p-v-o-s/sky-sweep/prototypes/sky-shield-v0.4-top.png

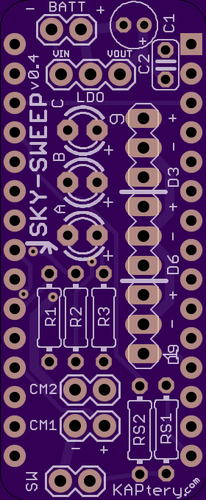
prototypes/sky-shield-v0.4-top.png
