p-v-o-s/sky-sweep/prototypes/sky-shield-v0.1-schem.png

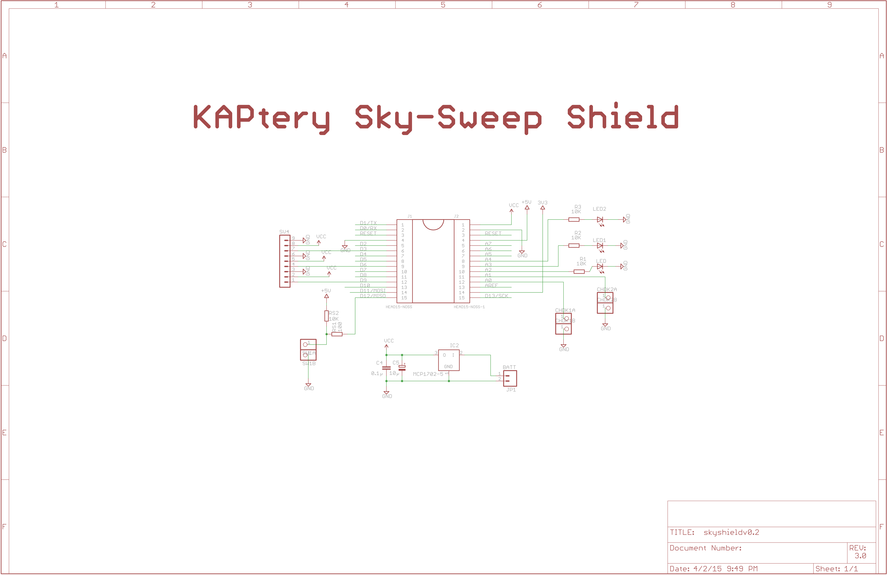
prototypes/sky-shield-v0.1-schem.png
