p-v-o-s/sky-sweep/prototypes/sky-shield-v0.5-board.png

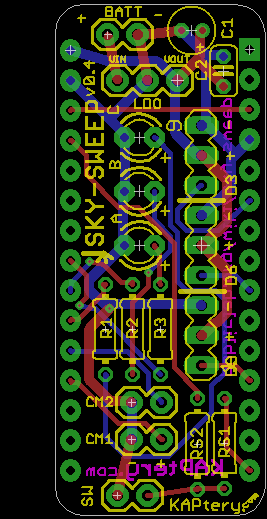
prototypes/sky-shield-v0.5-board.png
