p-v-o-s/sky-sweep/prototypes/sky-sweep-v0.2-bottom.png

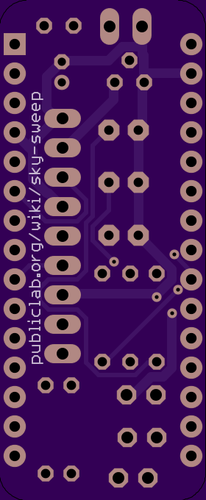
prototypes/sky-sweep-v0.2-bottom.png
