p-v-o-s/sky-sweep/ver_2.3/hardware/skyshieldv2.3-schematic.png

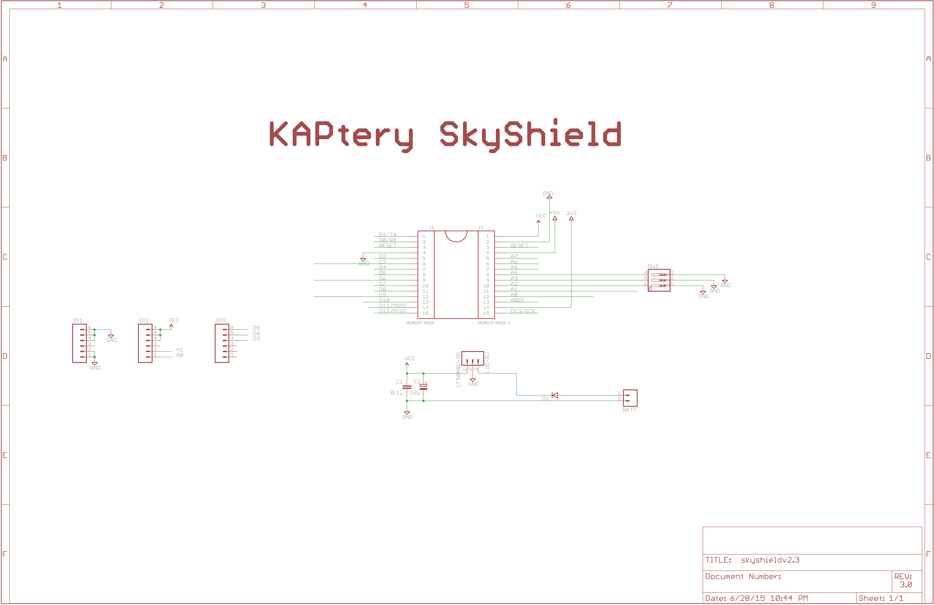
ver_2.3/hardware/skyshieldv2.3-schematic.png
