p-v-o-s/sky-sweep/(threads)

Thread 1 (2015-04-02):

add 5V voltage regulator from VIN

dwblair, 2015-04-02:
Might use this:

MICROCHIP  MCP1702-5002E/TO  LDO VOLTAGE REGULATOR, 5V, 250mA, TO-92-3

http://www.newark.com/microchip/mcp1702-5002e-to/ldo-voltage-regulator-5v-250ma/dp/56K6985?mckv=sGFSVLldl|pcrid|57087227901|plid|&CMP=KNC-GPLA?gross_price=

Closed 2015-06-05.

Thread 2 (2015-06-05):

Create BOM

dwblair, 2015-06-05:

Fastie, 2015-06-14:
Don,
I updated the SkyShield [bill of materials google sheet](https://docs.google.com/spreadsheets/d/1GBuHSpaCLA2EbN3OOJWe4kTiJWiZ1Trc5mMFSvcZXjI/edit#gid=2020475328). There are now sheets for Version 0.4 (in beta), Version 2.0 and 2.1 (at OSH, will have DIP switch) and Version 3 (not designed, will have boost converter). It would be good to place a Digi-Key order for DIP switches, resistor networks, and other stuff for Version 2 in the next few days. Could you source the resistor network, confirm my DIP switch choice, and confirm that Version 2 still needs the resistors and capacitors that version 0.4 needed?

I could also include in this Digi-Key order a boost converter and anything else needed for Version 3. That is not designed yet, but I hope it will be in time to order some PCBs from OSH as soon as Version 2.1 is confirmed to work (this month). That way we could have Version 3 back from OSH and ready to try when I return from field work. In fact, if you come up with a design for Version 3 like now, I will order a few and maybe get to test it before I ship out, which could move the timeline up by two weeks.

There are notes to you in the Google sheet.
Thanks

dwblair, 2015-06-14:
Great!  I'll get on resistor network, DIP switch, and associated resistors and capacitors ...

Love the boost converter idea.  I think the part that was pointed to was a 'surface mount' part, and I haven't looked at the associated 'package', but depending, it might be more or less easy as a DIY kit.  @bgamari  has pointed to the fact that some surface mount packages are actually easier to solder than through-hole, though, so maybe this will work out well ... will look into it.

Fastie, 2015-06-14:
Here are some [through-hole step-up boost converters at Digi-Key](http://www.digikey.com/product-search/compare/en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). These are all 8 pin ICs (7.6mm), so they take up a lot of room on the shield.   But they all cost <$0.65.

Fastie, 2015-06-14:
[Here are more](http://www.digikey.com/product-search/compare/en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) for mostly <$1.00 includiing some that are ratiometric, whatever that means. These are all through-hole ICs. Could these be soldered on the underside of the shield to allow something to go in its footprint on top?

bgamari, 2015-06-15:
@Fastie, be aware that the second group of parts (the "ratiometric" ones) actually produce a negative voltage (this type of device is known as a switched capacitor charge pump). You really want something like the parts in the first list, which are [buck-boost regulators](https://en.wikipedia.org/wiki/Boost_converter) (where you are instead using an inductor as your energy storage element).

Fastie, 2015-06-15:
Thanks Ben. Good to know what ratiometric means, and that we don't want it.

bgamari, 2015-06-15:
Well, to be clear it's not that you don't want a ratiometric part. "Ratiometric" in this case just means that the output voltage is proportional to the ratio of two external component values (in this case resistors).

Also, it seems I mixed up the two sets of parts that you cited. You can filter for the desired parts on Digikey's website by selecting the  "Boost" and "Buck-boost" topologies.

Fastie, 2015-06-15:
Hmm, all the boost and buck-boost through-hole converters are expensive ([cheapest ones](http://www.digikey.com/product-search/compare/en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)).
The surface mount versions are way more abundant and cheaper ([cheapest ones](http://www.digikey.com/product-search/compare/en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)).
Can we ask kit builders to solder on a surface mount component?

BobStevens, 2015-06-15:
I've been using the mini buck-boost modules from Pololu, on an unrelated
project, and they seem to work well. Easy to solder.
When used with servos an additional capacitor on the Vout helps a lot. But
perhaps too expensive to include in the kit.

The board and schematic can be found here...
https://www.pololu.com/product/2119/resources

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

bgamari, 2015-06-15:
Looks like they are a bit expensive and may not have the capacity to drive the load in question.

Fastie, 2015-06-16:
Thanks for that link Bob. That Pololu module seems to do just what we need, although it would be good to be able to handle about 1.5A. I haven't been able to find one of the IC modules at Digi-Key that is step-up/step-down and in the correct voltage range for a reasonable price. The servos seem to need between 4.8 and 6 volts. I think closer to 6V is better. There are lots of IC converters for under $2.00, but I'm not sure any of them do what we need. I'm still not sure adding $5.00 to the BOM is justified. I also don't know which of those surface mount converters can be soldered by hand.

I just got the news that six new SkyShield PCBs were shipped from Oregon today. So the more pressing need is the final components for SkyShield v2 and 2.1 (DIP switch, resistor network, etc.). A Digi-Key order should go in ASAP, then we have more time to figure out if a boost converter can be added for v3.

dwblair, 2015-06-16:
 Hallo!

Yes, let me get back in here and review the components for v2 and v2.1 ...

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

dwblair, 2015-06-16:
Good news: confirmed number of capacitors, added in resistor network option
on digikey!

Potentially bad news: in discussion w/ Ben, might've done something that
won't quite work w/respect to the DIP switch. Going to prototype it tonight
to find out ...

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

dwblair, 2015-06-17:
Update:

When I checked the parts for v.2.1 and v.2.2, something looked odd to me in
the switch circuit.  Specifically, there was no "ground" for any of the
switches -- so that when the switch is open, the voltage measured on the
analog pins will 'float'.  (This is in contrast with our other switch /
button circuit, which is grounded when it's not closed -- and is what
tipped me off.)

In conversation with @bgamari (The Oracle), he proposed a simple fix for
this.  Arduino pins are capable of 'internal pull-up resistors' -- i.e.,
through firmware code you can decide to connect individual pins to VCC via
an internal resistor.

So: if we connect the individual switches in the DIP switch to ground,
instead of VCC, we can also 'pull up' all of the resistors via an internal
pull-up resistor in firmware.

This doesn't work as a fix for boards version 2.0 and 2.1 -- in order to
fix those boards, you'll need to 'cut the trace' (the PCB metal connecting
the switches to VCC) on the board (done with a knife or equivalent), and
then solder a wire from the relevant pin on the resistor network to GND.
This won't be a great option for a commercial kit, and you likely won't
want to sell boards with this fix (though I'm sure you can do it in an
elegant way) -- but @bgamari pointed out that it might be worth ordering
the resistor network part in order to test the circuit at least once,
anyway.

The upside of this is that we can actually get away without using the
resistor network at all, making more space on the board (for, e.g., the
components required for a switching regulator -- which will require not
just the switching reg IC, but some additional capacitors / inductor / etc.)

Sorry for the goof-up.

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
>>> Thanks for that link Bob. That Pololu module seems to do just what we
>>> need, although it would be good to be able to handle about 1.5A. I haven't
>>> been able to find one of the IC modules at Digi-Key that is
>>> step-up/step-down and in the correct voltage range for a reasonable price.
>>> The servos seem to need between 4.8 and 6 volts. I think closer to 6V is
>>> better. There are lots of IC converters for under $2.00, but I'm not sure
>>> any of them do what we need. I'm still not sure adding $5.00 to the BOM is
>>> justified. I also don't know which of those surface mount converters can be
>>> soldered by hand.
>>>
>>> I just got the news that six new SkyShield PCBs were shipped from Oregon
>>> today. So the more pressing need is the final components for SkyShield v2
>>> and 2.1 (DIP switch, resistor network, etc.). A Digi-Key order should go in
>>> ASAP, then we have more time to figure out if a boost converter can be
>>> added for v3.
>>>
>>> —
>>> Reply to this email directly or view it on GitHub
>>> <https://github.com/p-v-o-s/sky-sweep/issues/2#issuecomment-112271345>.
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

dwblair, 2015-06-17:
Here's a new version of the shield (2.2) incorporating the changes
(simplified switch circuit):

https://github.com/p-v-o-s/sky-sweep/tree/master/ver_2.2/hardware

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
>>>  Hallo!
>>>
>>> Yes, let me get back in here and review the components for v2 and v2.1
>>> ...
>>>
>>> On Mon, Jun 15, 2015 at 11:23 PM, Fastie <notifications@github.com>
>>> wrote:
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

bgamari, 2015-06-17:
dwblair <notifications@github.com> writes:

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
Looks good to me.

Fastie, 2015-06-17:
So there is code you use in a sketch to make a particular pin gets its current through a resistor on the Nano? Only the pins used for the DIP switch will be routed through this resistor? Anybody know this code?
With some scratches and jumpers can I test this with the PCBs that will arrive soon? That is, without a resistor network, can I wire it up so the DIP switch works? Are any other components needed for this test?
If the next version will not have a resistor network, is there any reason to order one for testing?

BobStevens, 2015-06-17:
INPUT_PULLUP is the mode,
http://www.arduino.cc/en/Reference/PinMode
 On Jun 17, 2015 12:21 PM, "Fastie" <notifications@github.com> wrote:

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

dwblair, 2015-06-17:
 Actually, great point -- there's no need to order the resistor network. In
fact, *not* placing the resistor network makes  testing easier -- you can
connect a wire from one of the resistor network holes directly to ground,
without having to cut any traces.  So really, you only need wires and
solder.  There is one pin on the resistor network footprint that is
connected to VCC, but each of the other pins would simply be connected to
ground (each separately).

Thanks Bob for the link -- yes, that looks like the right code, there!

On Wed, Jun 17, 2015 at 12:26 PM, BobStevens <notifications@github.com>
wrote:

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

Fastie, 2015-06-17:
So for a 3 switch DIP, I will need 3 jumpers, each from ground to a different hole (where the resistor network would have been). Wouldn't that be the same as connecting all the holes and running one jumper to ground? Could you doodle the jumpers required?

One jumper should not bother potential beta testers, although the plan was to have this round of testers get a kit for soldering the PCB. This version might not make a good test of that.

 I will place an order for DIP switches, but I have enough of everything else.

I guess I could order some version 2.2 PCBs from OSHPark, but I won't get to try them until late July. Will there be a version 3 with boost converter by then? Or is finding a boost converter for <$5.00 going to be hard?

dwblair, 2015-06-17:
Ah, you're right -- all of the switch ends can be connected to ground together, so that's easier.

For some reason I'm unable to change the line color in Inkscape any longer. Oops.  But hopefully you can discern what I'm getting at here:

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

Not yet sure re: the boost converter ... but sounds reasonable to shoot for late July, fi we can find a cheap part ...

Fastie, 2015-06-17:
Thanks for the doodle. The jumpers could be underneath so they won't even show. For v 2.1 with a four-switch DIP, it should be as you show.  For v. 2.0 with a three-switch DIP, can I connect only three holes (which three)?
It sounds like this could be a quite functional SkyShield and the DIP switch is an important upgrade to test. I have all the parts for six new rigs printed, so I could run another beta test. I probably won't have time to assemble the rigs before I ship out, but maybe beta testers can test the whole kit process this time. I just have to create assembly instructions and the DIP switch code. Bob, thanks for the link to the  PinMode page.

Thread 3 (2015-06-05):

USB power flakiness -- exploring

dwblair, 2015-06-05:

Fastie, 2015-06-07:
I added to the description of this power issue sufficient detail that someone familiar with circuits and power could probably diagnose it.

bgamari, 2015-06-09:
Indeed most USB ports are limited to 500mA. A standard servo may draw upwards of an amp when starting. This almost certainly explains the behavior you see.

Also, something to note is that even when not moving some servos can draw quite a bit (tens of milliamps). A simple solution to both of these problems would be to put the servos behind a switch-mode boost converter. This will allow you to use fewer batteries (as the battery voltage is no longer constrained by the voltage requirements of the servos) and allows you to easily switch off the servos when not needed.

Fastie, 2015-06-09:
Thanks Ben. So USB 2.0 just can't supply the current that servos need.

A boost converter would solve that problem and supply more reliable power from batteries as well. It looks like a boost converter would cost as much as all the components of the SkyShield combined and be almost as big as the entire SkyShield.

I guess since the SkyShield functions as desired under battery power, which is the intended mode for aerial photography, it might be best to leave it as is. Testing new sketches downloaded via USB will require that battery power is on (whether USB is still connected or not).

Fastie, 2015-06-09:
Maybe we shouldn't lay all the blame on USB. USB connects to the Nano, not the SkyShield, so USB power getting to the pins on the shield goes through the Nano which is rated for only 40mA output. That is certainly not enough to drive servos, and a primary function of the SkyShield is to supply adequate power to the servos because an Arduino alone can't do that.

The 1.5A LDO voltage regulator on the SkyShield is a better power source than USB, but the 500mA direct from USB should be enough to handle the servo motion it is being asked to do.

Unless there are output pins on the Nano that could supply the USB current directly to the SkyShield, there are no changes to the SkyShield that could fix this problem. The servos will never work well if all the power they get is from the 40mA Nano output. If there is a pin on the Nano that supplies unfiltered USB power, the SkyShield could direct that to the servos, with or without regulation or boosting. Is there such a pin?

There must be, because the Funduino shield drives servos just fine and has headers intended to do just that. With USB connected to the Nano, servos plugged in to the Funduino operate as they should. What does the Funduino do that the SkyShield doesn't?

Fastie, 2015-06-10:
From this post: <http://electronics.stackexchange.com/questions/67092/how-much-current-can-i-draw-from-the-arduinos-pins>

"The 5V pin of the arduino is *not connected through the microcontroller.* As such, it can source significantly more power. When you are powering your arduino from USB, the USB interface limits your total power consumption to 500 mA. This is shared with the devices on the arduino board, so the available power will be somewhat less...

...The 5V output pin is good for ~400 mA on USB, ~900 mA when using an external power adapter."

I think the SkyShield uses this 5V pin on the Nano to get power when it is connected to USB. So it should have about 400mA to work with. That's not overly generous for servos, but should be plenty for testing. Is it possible that the SkyShield is preventing some of this current from getting to the servos?

bgamari, 2015-06-10:
Hmm. A simple boost converter should cost around a dollar with all of the passives. The converter itself will be roughly 20mm^2, with perhaps another 20mm^2 of routing and passives. Surely the board isn't *that* small. Moreover, the potential reduction in battery size would likely outweight the larger board area.

As far as the servos go, the problem may be a transient high current requirement. It is possible that some capacitance on the 5V rail may smooth out this transient

bgamari, 2015-06-10:
For instance, this would be one possible switcher, http://www.ti.com/product/lmr61428.

Fastie, 2015-06-10:
Ah, 60¢ and 3x5mm. That's more like it. My searches were finding something else.  That's even cheaper than the LDO on the SkyShield now.

The LDO is in the circuit right after the battery input, but that has no effect on power coming from USB. The boost converter could replace the LDO but get behind both the battery and the 5V pin so any power going to the servos gets boosted.

The battery we're using now is minimal because 4 AAA alkaline are only 6V and the servos should have at least 4.8V.  So when the batteries get a little worn out they stop driving the servos properly. I guess a boost converter could allow those same AAA to last much longer.

It sounds like a worthwhile addition.

bgamari, 2015-06-11:
Indeed, you could drop that down to 2 batteries at the expense of some capacity, some of which you would win back as the boost converter can maintain adequate rail voltage even as the battery voltages sag. With some effort you could probably find a boost converter with a minimum voltage of 1V, allowing you to operating with one alkaline battery although it's not clear it would give you enough capacity.

Fastie, 2015-06-11:
It might be best to stay with the four AAA so users can be confident that they have enough power to last for an afternoon of flying. With just two batteries, you would probably want fresh batteries for every one hour flight. Eventually you will send the rig up for an hour and then learn that the batteries lasted only 10 minutes, but with four AAAs and the right boost converter, that will happen on fewer flights.

Boost converters are available in through hole configuration, but there are zillions of them at Digi-Key. Our current LDO is mounted underneath the SkyShield so it takes up little space (it ends up between the SkyShield and the Nano).

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

Don, can you find an appropriate converter for 4 AAA and figure out if can fit on the SkyShield? The new SkyShield v2.1 will arrive in the next couple of weeks so its time to put in a Digi-Key order for components for those. So we need to select a resistor network and DIP switch, too. I can include in that order a couple of boost converters to try out for SkyShield V. 3.0.

dwblair, 2015-06-18:
Specs on this particular chip look maybe okay? https://learn.adafruit.com/adafruit-powerboost-1000-basic

Fastie, 2015-06-18:
It would be slick to be able to use two AAA instead of four. It would also be nice to use rechargeable batteries (which are 1.2V instead of 1.5V for alkaline). But that module is about half the size of the entire SkyShield, and costs more than all the other components combined (including the Nano).

There are two reasons to change the power circuit.

 -   1) fix the issue about USB power not driving servos correctly, and
 -   2) supply more carefully regulated power so batteries last longer and so fewer batteries are needed.

Is it possible to move the LDO we now use so that it regulates the power coming from the USB port on the Nano? Would this fix problem 1?

The existing configuration works really well in flight. Four AAA batteries last for at least 1.5 hours and maybe much longer (not yet tested). Lifting four AAA is not an obstacle to kite photography most of the time. So that part (number 2) ain't really broke.

I don't think it's worth adding 50% or 100% to the BOM to fix either 1 or 2, but if there is a way to fix problem 1 without adding more than a few dollars and enlarging the SkyShield footprint, it would be great to find it.

bgamari, 2015-06-18:
@Fastie I suspect Don was suggesting the chip on that board (the [TPS61030](http://www.ti.com/product/tps61030)) and not the board itself. It is [available](https://octopart.com/search?q=TPS61030) in a TSSOP package in single quantities for about $3. It's certainly not the cheapest option but I agree that the specs look pretty nice.

Fastie, 2015-06-23:
Just came across [this on Adafruit](https://learn.adafruit.com/adafruit-arduino-lesson-14-servo-motors/if-the-servo-misbehaves):
"Your servo may behave erratically, and you may find that this only happens when the Arduino is plugged into certain USB ports. This is because the servo draws quite a lot of power, especially as the motor is starting up, and this sudden high demand can be enough to drop the voltage on the Arduino board, so that it resets itself.
If this happens, then you can usually cure it by adding a high value capacitor (470uF or greater) between GND and 5V..."

Ben suggested this above 13 days ago. Is there any sacrifice to adding a big capacitor like this?
[These cost <50¢ ](http://www.digikey.com/product-search/compare/en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)

bgamari, 2015-06-23:
Fastie <notifications@github.com> writes:

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
There isn't much of a sacrifice beyond the volume of such a capacitor,
per se. That being said, I would argue that a switching regulator offers
far more in terms of benefits. Not only is it substantially more
efficient than an LDO, but it allows you to use fewer batteries for
a larger portion of their discharge curve.

A switcher may not be quite as simple as a simple cap but you can be fairly certain that
it will work (in contrast to the cap) and it offers a number of
additional advantages.

Fastie, 2015-06-23:
Yes, those are big caps, typically 8mm diameter and 16mm tall.  If placed cleverly, one could fit between the Nano and the shield and add nothing to the footprint. And it would add only 50¢ to the BOM, keeping it under $10.00 total.

I have not yet seen a description of how many components would be required to implement a boost converter, how much space they would require, and how much they would cost.

I'm not capable of that circuit design, so i think the SkyShield with a boost converter is a second generation device. If Don can incorporate the deck chair changes we outlined in [another thread](https://github.com/p-v-o-s/sky-sweep/issues/12), I can order a few v2.3 PCBs this week so they are available when my field work is done mid July. If they test well, I might order a bunch and offer the first retail kits for sale in early August before the KAP season ends.

After v2.3, the next priority could be to breadboard a big capacitor to see if it helps. Don has all the components he needs for that experiment except for the 470 uF cap.

In the meantime, version 2.0 is in beta for anybody who wants one: <http://publiclab.org/notes/cfastie/06-23-2015/skyshield-v2-beta>

Thread 4 (2015-06-05):

Replace push-button with dip switch

dwblair, 2015-06-05:

Closed 2015-06-05.

Thread 5 (2015-06-05):

tilt servo is grinding / making noise

dwblair, 2015-06-05:

Fastie, 2015-06-05:
The screw holding the camera tray onto the servo spline has to be very tight. But if it is too tight, it can interfere with the servo operation and make it work all the time.

Thread 8 (2015-06-06):

Do I have to set the tilt position of the camera tray before starting?

Fastie, 2015-06-06:

Fastie, 2015-06-06:
Pat thought the camera tray was at the wrong angle and wondered if he should reposition it before a flight. The answer is probably No. The camera tray should be attached to the spline of the tilt servo so that it is in the correct position and cannot slip out of adjustment.  Standard servos like the tilt servo know what position they are in. The rotation angle of the tilt servo is addressable by the Arduino sketch which can position the camera tray exactly regardless of the tray's position when the power is off. Most of the modes in the sketch should make the camera point straight down (the last tilt position of a sequence). This is something to check when testing the rig. If the lowermost tilt position does not point the camera straight down, something needs to be adjusted.

Thread 9 (2015-06-06):

Camera USB cable attachment to SkyShield header is lame.

Fastie, 2015-06-06:

dwblair, 2015-06-06:
Well I never.

(ooh -- should we use a microUSB thingy?)

Fastie, 2015-06-06:
Pat faced one of the more tricky aspects of operating the Saturn V Rig on his first attempt to fly it.  The standard way to connect a cable to a PCB is with a header. One or a few pins stick up from the header and a plastic connector fits over the pins. The only thing that holds the two together is metal-to-metal friction. The camera cable is stiffer than typical servo leads, and when the camera tilts it pulls on the cable. The connector needs only two pins, so it is not as sturdy or tight as a three pin connector.    To compensate for this, the cable has a Velcro strap on it which can hold the cable firmly in place.

During launch, you might need to press the button on the SkyShield to select the mode, and that requires moving the SkyShield which can dislodge the camera cable connector. Trying to plug that connector in again while the kite is flying and the Picavet lines are getting wrapped around the turning gears is tricky and can result in the header pins getting bent. It's easy to bend the pins straight again, but eventually they will divorce themselves from the PCB.

The interim solution is to avoid last minute access to the SkyShield. Get familiar with plugging that connector in and get everything set before the kite flies. Of course selecting any mode other than Mode 0 will always require access to the button (but that will change with SkyShield v2.1).

Is anyone familiar with better connectors that could replace the standard servo connectors and be really cheap and easy to use (kit builders will have to make their own camera cables)?

Fastie, 2015-06-08:
Don, a micro USB connector could work instead of the present header. I can buy cables ready made for that (male to male, right angle USB mini to straight USB micro, 25 cm long).  But those cables cost $2 more than the ones I have been modifying, and the USB micro connector costs a dollar more than a header. Plus it's hard to mount a USB connector vertically and make it strong.

dwblair, 2015-06-08:
 hmmm ... could we shift the switch and place two mini usb headers facing
'out' at the 'bottom' of the board?

b/c these are pretty cheap
http://www.monoprice.com/Product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

but you're right, the usb connectors do cost more ...

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

Fastie, 2015-06-08:
I think the cable we need is right angle mini B (for the camera) to micro B (for the shield), and about 25 to 30 cm long. We could use mini B instead of micro B on the shield but I assume those are bigger.

However, USB on the shield is really more than we need. We need to connect only two wires, and space and accessibility are limited (USB connectors are fat). A simple snap on connector should be easy to find for $0.30 and then we have to solder its mate onto the other end of a right angle mini B USB cable.

Although Pat is having repeat trouble keeping that cable connected during flight, I think it will work for him eventually.  So unless there is consensus that the current cable is unworkable, we would have to find a really nice substitute for the ubiquitous RC connector. The planned kit will include two RC connectors, one to attach to the wires from the battery case, and one for the camera USB cable (the servos come ready to connect).

When I built the two SkyShields for Kitty and Scott, I squirted some hot glue around the header for the camera connectors. That should beef them up some. So if you follow the instructions for mounting everything, it should be quite reliable.

Fastie, 2015-06-08:
On further consideration, a ready-made cable would be really nice for kit builders. That is, making your own USB to RC connector cable is not trivial. I just made the two for Scott's and Kitty's rigs. I'm getting good at it, but it's a lot to ask a kit builder to do.

So a female USB connector on the SkyShield would please a lot of people. I can't find any cables for sale that are ideal. The camera connection should be a right angle mini B (straight works for most cameras, but right angle is the best solution). The SkyShield connection should be micro B, but that cable does not exist. However, there are right angle mini B to straight mini B for sale: <http://www.ebay.com/itm/190925729450>. So if a mini B female connector can be mounted vertically on the SkyShield, it might be worth adding a couple of extra dollars to the BOM. This might work: <http://www.digikey.com/product-detail/en/1734753-1/A107790-ND/4021671>.
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

There has to be only one of these. The second camera connection can be an RC header. Most people won't use it at all, and those that do can deal with it. It should be vertical because all of the other connectors are vertical and the whole thing becomes a spider explosion if things also have to be connected sideways. It has to be away from the edges of the SkyShield so it can be reached through the gap under the pan servo. The current location of CM1 and CM2 is good, but the fatter USB connector probably requires it to be farther toward the middle of the PCB. It will need some space around it for the fat connector.

Fastie, 2015-06-09:
A simpler way to solve this problem is to construct the custom camera cables differently. I have been attaching RC connectors to the cut end of a USB cable because that makes a very tidy cable. Instead I could use a pre-made RC lead (thin wires with RC connectors at both ends) and cut one connector off. Then the cut ends of the servo lead and the USB cable get spliced together. That is much easier soldering. It also avoids the problem of a stiff USB cable yanking on the connector at the SkyShield. The thin wires of the RC lead are more flexible and won't transfer the motion of the tilting camera as well. The cable could be secured (e.g., with Velcro as per the current design) to make it even more secure.

That strategy requires more common materials (servo leads are cheap and right angle mini B USB cables are a commodity item). So it doesn't add more than 50¢ to the BOM. No change in the SkyShield configuration is required.

Fastie, 2015-06-13:
The camera cable I made for the sixth Saturn V Rig used a right angle USB cable and a servo wire. I chopped them both and spliced them together. It's a much easier build process and it worked great. The flexible servo wires have enough slack that the SkyShield can be pulled out without bothering the Velcro holding the cable.
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
.
When I had to select a mode by pressing the black button, I did not move the SkyShield, but used a wooden dowel (spare rig leg) that was in my pocket for that purpose. A non-conductive material is recommended.

Thread 10 (2015-06-13):

Camera does not point straight down at lowest tilt position

Fastie, 2015-06-13:
The angle of rotation of the tilt servo can be addressed absolutely by the Arduino sketch – tell it to go to 93° and it will. But neither the sketch nor the servo know in what orientation the servo is mounted, so one of the last things to do when configuring a Saturn V Rig is to establish this correct physical relationship. I run a sketch until it tells the tilt servo to point the camera straight down and then stop the sketch. I then attach the camera tray to the spline of the tilt servo so the camera will point straight down.

The spline at the end of the servo axle has 15 teeth which engage with a socket on the camera tray. Each tooth represents 24 degrees of rotation (360/15=24), so adjusting the absolute aim of the camera cannot be done with any more precision than that. The best possible adjustment may not cause the camera to point straight down when the sketch tells it to. That’s okay because in each complete pan/tilt regime, the nadir will be included in all eight or nine photos taken in the lowest tilt position. So there is plenty of nadir coverage, but if you wanted to use those photos for mapping, it would be nice to have them as vertical as possible.
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
The exact tilt angle can be adjusted in hardware or software. The socket on the camera tray can be rotated, but this means drilling two new bolt holes. The easiest fix is to edit the sketch so that the lowermost tilt position makes the camera point at the nadir. The tilt positions are established in three arrays at the very beginning of the sketch. Change the last number in an array from the current value (originally 20) to 10 or 30 or whatever works. This will change the increment between the last two tilt positions, but there is lots of overlap built in so it won’t matter much.

The beta rigs I shipped all seemed to point pretty close to vertical when they should, but it’s a good thing to check if you want the lowest tilt to point exactly vertical. If you have to remove the camera tray to drill a hole for the tripod screw, you will have to run the sketch to get the tilt servo into its lowest position when you replace the tray. Select Mode 4 for this because it tilts first, then pans.

Thread 11 (2015-06-21):

Version 2.0

Fastie, 2015-06-21:
Six SkySweep PCBs arrived in the mail today from OSH Park, simultaneously with DIP switches from Digi-Key. I had to plant the final 50 vegetable starts this afternoon, but after dinner I started soldering.

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
*Doesn't look very pretty without the colorful LEDs, and I tried to make the ground header pins black with a sharpie, and strengthen the camera headers with hot glue. But it works. Mode 7 is selected.*

Coding the DIP switch is much easier than the tactile button and LEDs -- seven lines of code instead of 40. Everything worked the first time the new sketch was loaded.

Question: I assume there is no reverse polarity protection on the SkyShield. Should there be? (Yes). In the previous version, the tall capacitor prevented the battery connector from being plugged in wrong. In this version it is quite easy to connect the battery backwards. Is that easy to fix with a diode somewhere?

A warm, gentle rain is caressing my tiny Brussels sprouts and leeks.

dwblair, 2015-06-22:
NICE!

Should we put some LEDs back on the board as optional indicators?

Reverse polarity does indeed sound like a good idea.  Does seem like we can
do this with a simple diode ... will look into it ...

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

Fastie, 2015-06-22:
LEDs are nice, but my fascination with blinking lights will wear off soon.

A diode will lower the current some, so I guess there is a cost. We are starting with 6V (four alkaline AAA), and the servos need at least 4.8V and would rather have 6V. But if people can fry the Nano by plugging the battery connector in wrong, we should have a diode.

bgamari, 2015-06-22:
@Fastie strictly speaking it will drop the voltage a bit. What you want is a [Schottky diode](https://en.wikipedia.org/wiki/Schottky_diode), which has a very low forward voltage drop.

Fastie, 2015-06-22:
Hooray for Schottky. Something like this?
<http://www.digikey.com/product-detail/en/SR203-TP/SR203-TPCT-ND/950551>
Thanks Ben.

bgamari, 2015-06-22:
Fastie <notifications@github.com> writes:

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
Yep.

Thread 12 (2015-06-21):

Version 2.3

Fastie, 2015-06-21:
Using a Sharpie to make the headers for ground pins black is messy. Check out how this is done on the Funduino shield:
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

I have black, red, and yellow male headers. If the headers for the three servo connections on the SkyShield could be in a 3x3 block instead of a line of nine pins, we could do this. I think this helps the user know how to plug in the connectors and avoids bad mistakes.

We could also put the two camera headers in the same block. The camera connectors need only two pins (G and V), but a third unused pin will make the connection stronger. With the new DIP switch and brilliant use of the Nano's built in pull-up resistor, I think there might be room now for a 3x5 block of headers.

Can we have this for version 2.3, please?

Fastie, 2015-06-21:
#### Some cosmetic changes for V 2.3 of the PCB:
Let's go with name "SkyShield" instead of "SKY-SWEEP"
The DIP switch seems to be labeled with "SW" and "SW2" which overlap.
We can eliminate the wiki URL on the underside.
Maybe this URL is better for the underside: https://github.com/p-v-o-s/sky-sweep

dwblair, 2015-06-22:
Cool!

Okay, we should put together a list of items for version 2.3 ...

- Cosmetic stuff (above)
- Servo header changes
- Camera header changes
- Fix the wiring on the DIP switches
- ?

Fastie, 2015-06-22:
Is the DIP wiring is already fixed in V 2.2?

Here is a doodle of the new header block:
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

BobStevens, 2015-06-22:
There is a locking pad/hole pattern for 0.1" headers in the Sparkfun eagle library. This might ease the assembly and soldering of those headers. The pattern of the pad/holes are slightly staggered and grip the headers in place before soldering.

Thread 13 (2015-06-25):

Where are the latest sketches?

Fastie, 2015-06-25:
The latest sketches to run the SkyShield are at the KAPtery: <http://kaptery.com/guides/>.

There are three versions of the sketch, one for each beta version of the SkyShield:

 - v.04  button and LEDs
 - v2.0 4-switch DIP
 - v2.1 3-switch DIP

Each version now has a mode for cameras with 37mm focal length lenses. Pat tried a PowerShot A495 and found that Mode 0 panned too far each time for the 37mm lens. Mode 6 now has 10 pan positions per rotation. This is Mode 8 on v2.0 which has 16 modes (modes 9-15 are repeats of modes 1-7 as placeholders). This mode has not been tested at all.

Fastie, 2015-09-21:
I just updated the SkySweep sketch to version 2.07, and it now has a working mode for non-360° coverage. The sketch can be downloaded at the [KAPtery Guides page](http://kaptery.com/guides/). This sketch will not work on the original SkyShield (v 0.4) or the version 2.0 with a four switch DIP, but the code could be incorporated into older SkySweep sketches.

The new mode captures a 4x4 grid of photos and probably works best with wide angle lenses (around 24 mm equiv.)  Let us know if you modify the sketch for other grids or other lenses.

There is more about the new sketch at the [KAPtery](http://www.kaptery.com/article/serpentine/).

I could not figure out how to store the name of an array in a variable and then use that variable to access the array. If anyone knows how to do that in a sketch, let me know. It might save two whole lines of code.

Thread 14 (2015-06-28):

Where are the assembly and use instructions?

Fastie, 2015-06-28:
Guides to assembling, configuring, and using the Saturn V Rig with SkyShield KAP controller are at the [KAPtery Guides page](http://www.kaptery.com/guides/). These might be updated periodically (they just were), so don't print them unless you have to.

smathermather, 2015-06-29:
Awesome!

Thread 15 (2015-07-19):

Version 2.3 power play

Fastie, 2015-07-19:
The new version of the SkyShield PCB (V 2.3) arrived last week and has undergone some testing.

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

There is apparently a difference between the new version and previous versions in the power issue that is discussed in [another issue](https://github.com/p-v-o-s/sky-sweep/issues/3). The previous boards did not drive servos correctly when powered by USB. This has not changed. But the new boards also do not drive servos correctly when powered by weak batteries that are strong enough to work fine with the previous boards. This is not a terrible failure, but I am really curious about the cause. Below are some test results. (I guess the markdown table will not display unless you view it at GitHub)

Table 1. Capability (Good or Bad) of SkyShield (Version 2.1 and 2.3) to drive servos correctly with different configurations of caps and diodes and power sources.

Power | V2.1 (10uF Cap, no diode) | V2.3 (10uF Cap & diode) | V2.3 (470uF Cap, no diode) | V2.3 (520uF Cap & diode)
------------- | ------------ | ------------- |------------- | ---------------- | ----------------
USB  | Bad | Bad | Bad | Bad
4 Weak AAA | Good | **Bad** | Good | Good
4 OK AAA | Good | Good | Good | Good
9V battery | Good | Good | Good | Good

The observations were designed to test two hypotheses about the cause of the power issue.

- 1. **The diode** -- The new version (2.3) is the first version to have a diode for reverse polarity protection. The diode reduces the current some, so that could contribute to the power problem. In addition to the results above, I did a more explicit test (with and without the diode) which suggests that the diode is not the problem.
- 2. **The capacitor** -- A large capacitor is sometimes used to get better performance from servos driven by Arduinos. I replaced the 10uF cap with 470uF and 520uF caps and observed no improvement when on USB power. However, a big cap on the new board (v2.3) does allow servos to operate correctly on battery power that is too weak for the original configuration (10uF cap) of the new board.

The capacitor result at least confirms that the erratic servo behavior is a power problem. The big capacitors used are sort of bulky, so maybe I will try some intermediate caps to see if I get the same improvement with something easier to fit on the board.

**Traces** -- A third hypothesis is harder to test. The new version was manufactured with thinner traces on the PCB (compare [v2.1](https://github.com/p-v-o-s/sky-sweep/blob/master/ver_2.1/hardware/skyshieldv2.1-board.png) with [v2.3](https://github.com/p-v-o-s/sky-sweep/blob/master/ver_2.3/hardware/skyshieldv2.3-board.png)). Most of the power traces on the old version were nice and wide, and a few power traces were medium width. On the new PCB (v2.3) none of the traces are wide, and some are skinnier than any on the old version. So most of the power traces on the new PCBs are medium width, but the new diode loop is really skinny. I jumped that skinny loop (to operate without diode or skinny power traces) and did not observe any improvement. But I can't test whether the medium traces are too narrow and are causing the problem.

Is it reasonable to assume that the thin (medium) power traces are contributing to the power problem?

**Circuit** -- A fourth hypothesis is beyond my ability. The only new component on the new PCB is the diode, but the routing was all changed to accommodate rearrangement of headers, etc. It is possible that there is something about [the new circuit](https://github.com/p-v-o-s/sky-sweep/tree/master/ver_2.3/hardware) that could be exacerbating the power issue? The new board is completely functional, it just can't operate on batteries quite as worn out as the older version. This seems like a mystery worth investigating.

Fastie, 2015-07-21:
I extended the table of results today with a 100uF cap and a 1000uF cap. The 100uF cap is no improvement over the 10uF cap. The weak battery still allows erratic servo behavior. The 1000uF cap made a big difference. The weak battery operated the servos normally, and even USB power worked fairly well. USB power did not drive the servos perfectly, but it was the best USB performance I have seen.
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
*Above: testing a 1000uF cap.*

So I guess this is all consistent with the hypothesis that the servos need more current than our original configuration supplies when the batteries are weak. It seems like it is worthwhile replacing the 10uF cap with one between 100uF and 470uF. USB power will still not drive the servos correctly, but batteries can run down and still drive the servos well. This change does not cost anything, because 470uF caps cost about the same as 10uF caps.

But I am working with no understanding of how this circuit works, so I could be missing something important.

Fastie, 2015-07-21:
The traces on the new v2.3 PCBs are of two widths. In the Eagle files submitted to OSHPark, the signal traces are 6 mil, and the power traces are mostly 15 mil. In the previous version of the PCB (the one that works well even with weak batteries and a 10uF cap), the power traces were mostly 32 mil, and the signal traces were mostly 15 mil.

I think OSHPark uses 1 ounce copper (1 oz/square foot) for its traces. For 2 amps of current, the recommended trace width for 1 ounce copper is 31 mils.  The servos are probably not drawing more than 1 amp very often, but maybe they are sometimes.

I guess its possible that the skinny traces are part of the problem with v2.3. So today I learned how to use Eagle CAD and made all the power traces 32 mils wide.

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
*Above: Top views of the board and the copper traces for v2.4.*
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
*Above: The bottom side of the board and copper traces on the bottom layer of v2.4.*

I had to do a little rerouting, and I was barely in control of what was happening, so it's not clear whether this circuit will actually work. But I have some confidence that those traces are plenty wide. How many should I order?
