p-v-o-s/sky-sweep/ver_2.3/hardware/skyshieldv2.3.brd

## EAGLE design ver_2.3/hardware/skyshieldv2.3.brd (2015-06-29)

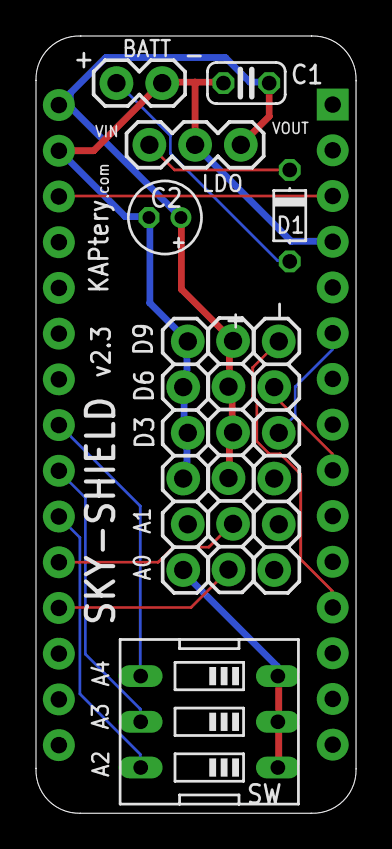
[picture p12: board skyshieldv2.3.brd from above]

Board: 2 copper layers, 17.8 x 43.2 mm, 11 parts (0 on the bottom side), 13 nets.

Parts:
BATT: 1X02
C1: 0.1µ; C025-024X044
C2: 10µ; E1,8-4
D1: D-5
J1: HEAD15-NOSS
J2: HEAD15-NOSS-1
JP1, JP2, JP3: 1X06_LOCK
LDO-5V: LF50ABV-DG; 1X03
SW2: EDG-03

Connections:
A0: J2.12, JP2.1
A1: J2.11, JP2.2
A2: J2.10, SW2.6
A3: J2.9, SW2.5
A4: J2.8, SW2.4
D3: J1.6, JP3.4
D6: J1.9, JP3.5
D9: J1.12, JP3.6
GND: BATT.2, C1.2, C2.-, J1.4, J2.2, JP1.1, JP1.2, JP1.4, JP1.5, JP1.6, LDO-5V.2, SW2.1, SW2.2, SW2.3
unnamed: BATT.1, D1.A
unnamed: D1.C, LDO-5V.3
RESET: J1.3, J2.3
VCC: C1.1, C2.+, J2.1, JP2.4, JP2.5, JP2.6, LDO-5V.1
