p-v-o-s/sky-sweep/ver_2.2/hardware/skyshieldv2.2.brd

## EAGLE design ver_2.2/hardware/skyshieldv2.2.brd (2015-06-17, an earlier design)

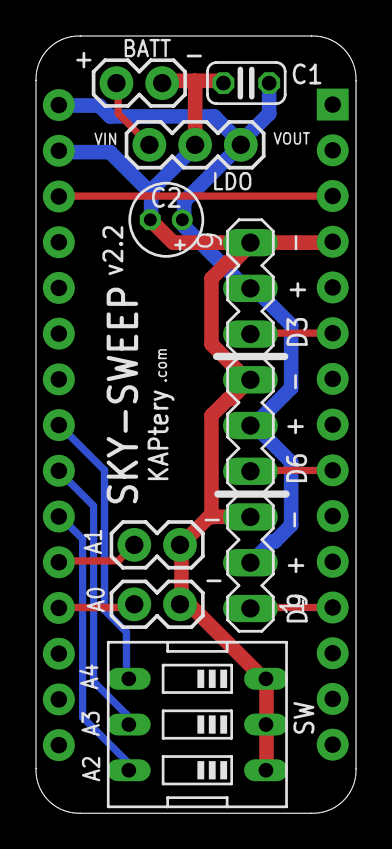
[picture p13: board skyshieldv2.2.brd from above]

Board: 2 copper layers, 17.8 x 43.2 mm, 10 parts (0 on the bottom side), 12 nets.

Parts:
BATT: 1X02
C1: 0.1µ; C025-024X044
C2: 10µ; E1,8-4
CHDKA: 1X02
CHDKB: 1X02
J1: HEAD15-NOSS
J2: HEAD15-NOSS-1
LDO-5V: LF50ABV-DG; 1X03
SV4: MA09-1
SW2: EDG-03

Connections:
A0: CHDKA.2, J2.12
A1: CHDKB.2, J2.11
A2: J2.10, SW2.6
A3: J2.9, SW2.5
A4: J2.8, SW2.4
D3: J1.6, SV4.7
D6: J1.9, SV4.4
D9: J1.12, SV4.1
GND: BATT.2, C1.2, C2.-, CHDKA.1, CHDKB.1, J1.4, J2.2, LDO-5V.2, SV4.3, SV4.6, SV4.9, SW2.1, SW2.2, SW2.3
unnamed: BATT.1, LDO-5V.3
RESET: J1.3, J2.3
VCC: C1.1, C2.+, J2.1, LDO-5V.1, SV4.2, SV4.5, SV4.8
