p-v-o-s/sky-sweep/prototypes/skyshieldv0.3.brd

## EAGLE design prototypes/skyshieldv0.3.brd (2015-04-03)

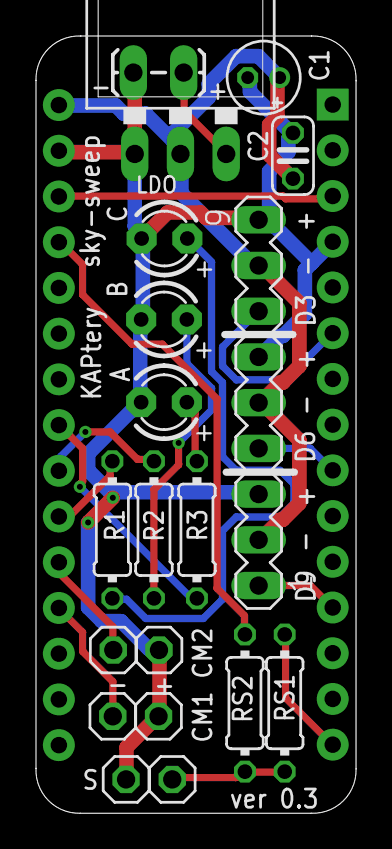
[picture p14: board skyshieldv0.3.brd from above]

Board: 2 copper layers, 17.8 x 43.2 mm, 21 parts (0 on the bottom side), 18 nets.

Parts:
C1: 0.1µ; C025-024X044
C2: 10µ; E1,8-4
CHDK1A, CHDK1B, CHDK2A, CHDK2B: 1X01
IC1: LD117AV; TO220L1
J1: HEAD15-NOSS
J2: HEAD15-NOSS-1
JP1: BATT; 1X02_LOCK_LONGPADS
LED, LED1, LED2: POWERLED; LED3MM
R1, R2, R3: 10K; 0204/7
RS1: 100; 0204/7
RS2: 10K; 0204/7
SV4: MA09-1
SW1A, SW1B: 1X01

Connections:
+5V: J2.4, RS2.1
A0: CHDK1A.1, J2.12
A1: CHDK2A.1, J2.11
A2: J2.10, R1.1
A3: J2.9, R2.1
A4: J2.8, R3.1
D3: J1.6, SV4.7
D6: J1.9, SV4.4
D9: J1.12, SV4.1
D12/MISO: J1.15, RS1.2
GND: C1.2, C2.-, CHDK1B.1, CHDK2B.1, IC1.1, J1.4, J2.2, JP1.2, LED.K, LED1.K, LED2.K, SV4.3, SV4.6, SV4.9, SW1B.1
unnamed: LED2.A, R3.2
unnamed: LED1.A, R2.2
unnamed: LED.A, R1.2
unnamed: RS1.1, RS2.2, SW1A.1
unnamed: IC1.3, JP1.1
RESET: J1.3, J2.3
VCC: C1.1, C2.+, IC1.2, J2.1, SV4.2, SV4.5, SV4.8
