p-v-o-s/sky-sweep/prototypes/skyshieldv0.1.brd

## EAGLE design prototypes/skyshieldv0.1.brd (2015-06-04)

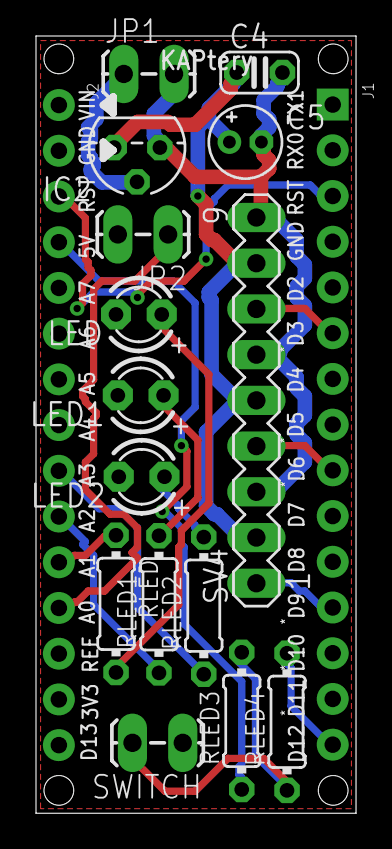
[picture p15: board skyshieldv0.1.brd from above]

Board: 2 copper layers, 17.8 x 43.2 mm, 18 parts (1 on the bottom side), 18 nets.

Parts:
C4: 0.1µ; C025-024X044
C5: 10µ; E1,8-4
IC2: MCP1702-5; TO92
J1: HEAD15-NOSS
J2: HEAD15-NOSS-1
JP1: BATT; 1X02_LOCK_LONGPADS
JP2: USB; 1X02_LOCK_LONGPADS
LED, LED1, LED2: POWERLED; LED3MM
RLED, RLED1, RLED2, RLED3, RLED4: 1.5K; 0204/7
SV4: MA09-1
SWITCH: adafruit; 1X02_LOCK_LONGPADS
U$54: FIDUCIAL1X2; FIDUCIAL-1X2

Connections:
+5V: J2.4, RLED3.1
A0: J2.11, RLED.1
A1: J2.10, RLED1.1
A3: J2.9, RLED2.1
COM: J1.4, J2.2, JP2.2, LED.K, LED1.K, LED2.K, SWITCH.1
D3: J1.6, SV4.7
D6: J1.9, SV4.4
D9: J1.12, SV4.1
D12/MISO: J1.15, RLED4.2
GND: C4.2, C5.-, IC2.1, JP1.2, SV4.3, SV4.6, SV4.9
unnamed: LED2.A, RLED2.2
unnamed: LED1.A, RLED1.2
unnamed: LED.A, RLED.2
unnamed: RLED3.2, RLED4.1, SWITCH.2
unnamed: J2.12, JP2.1
PWR: IC2.2, JP1.1
RESET: J1.3, J2.3
VCC: C4.1, C5.+, IC2.3, SV4.2, SV4.5, SV4.8
