p-v-o-s/sky-sweep/(notices)

Notices in the files:
prototypes/skyshieldv0.1.sch:
Copyright 2009 under the Creative Commons Attribution Share-Alike 2.5 License
http://creativecommons.org/license/by-sa/2.5
parts and their libraries:
SparkFun-Connectors: Licensing: Creative Commons ShareAlike 4.0 International - https://creativecommons.org/licenses/by-sa/4.0
